GV-ing/ARCHIMEDE/Images/DriverDC.jpg

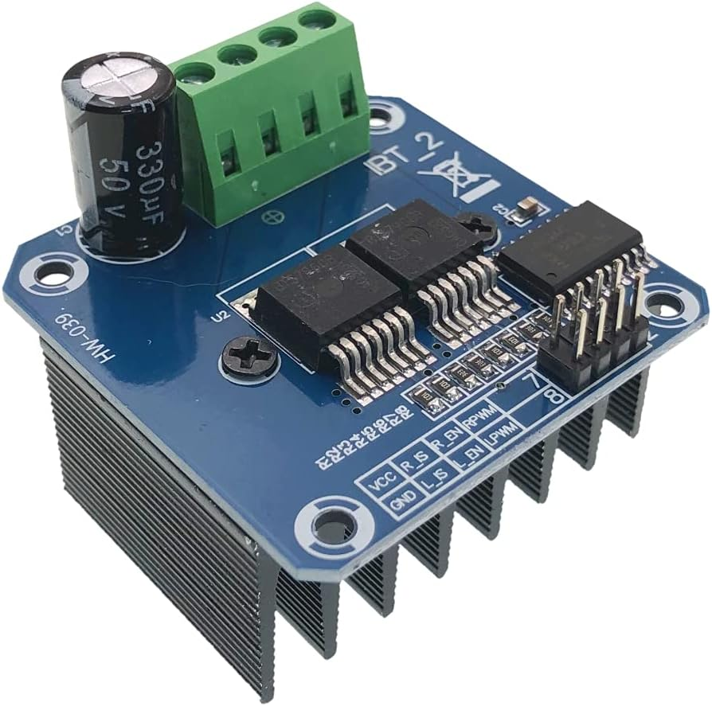
Images/DriverDC.jpg
