GV-ing/ARCHIMEDE/Images/driver.png

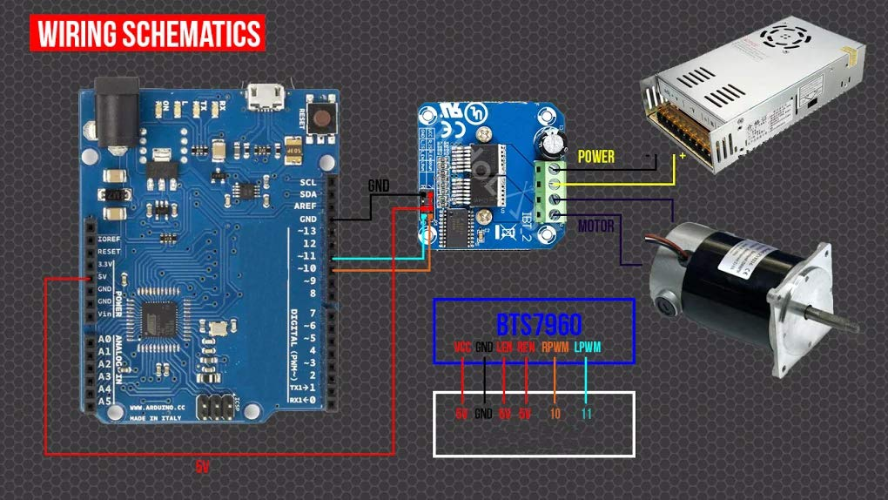
Images/driver.png
