GV-ing/ARCHIMEDE/Thesis/presentazioneTesiGiulioVestri.pdf

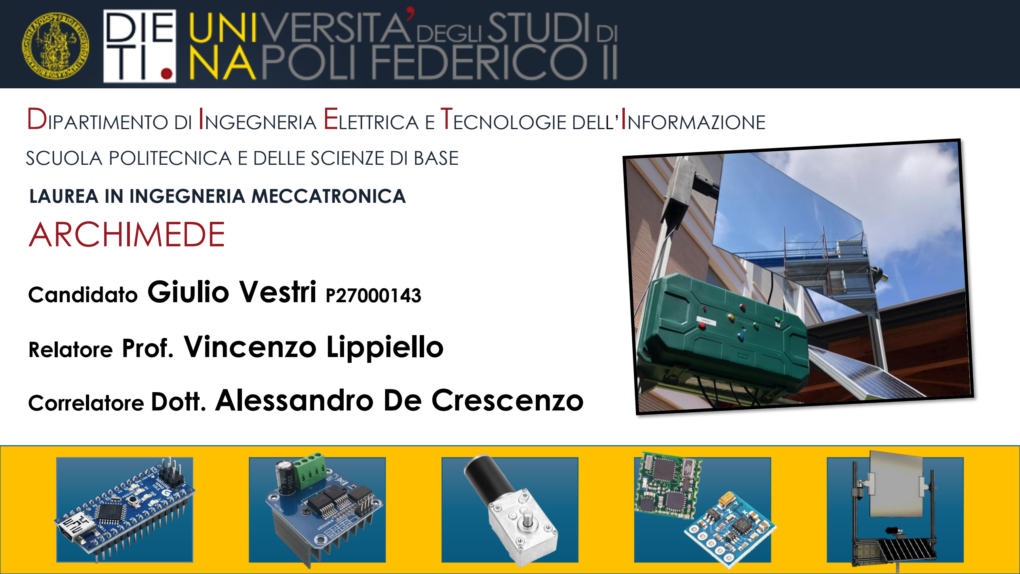
[picture p3: page 2]

DIPARTIMENTO DI INGEGNERIA ELETTRICA E TECNOLOGIE DELL’INFORMAZIONE

SCUOLA POLITECNICA E DELLE SCIENZE DI BASE

# ARCHIMEDE

## Candidato Giulio Vestri P27000143

## Relatore Prof. Vincenzo Lippiello

## Correlatore Dott. Alessandro De Crescenzo

LAUREA IN INGEGNERIA MECCATRONICA

Neabotics

Startup innovativa e
spin-off del laboratorio
di robotica PRISMA Lab

Specializzata nello
sviluppo di soluzioni
robotiche avanzate

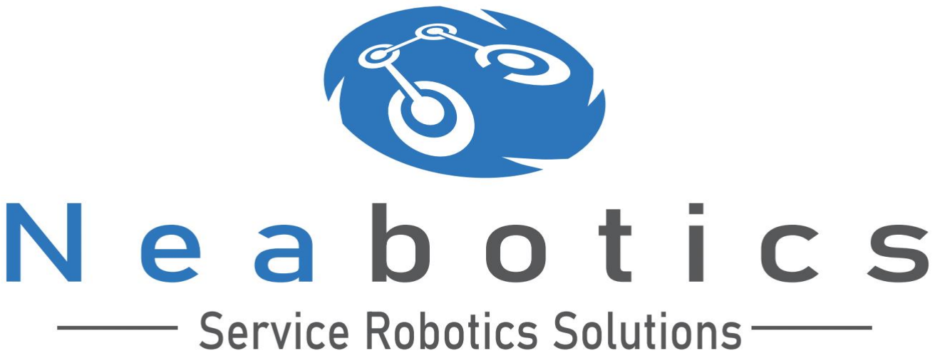
[picture p4: figure]

Steps di progettazione

# Specifiche di progetto

Il sistema doveva essere in grado di riflettere i raggi del sole verso un target selezionabile, modificando il proprio orientamento in base al movimento del sole, al fine di garantire l’illuminazione del target durante l’arco della giornata.

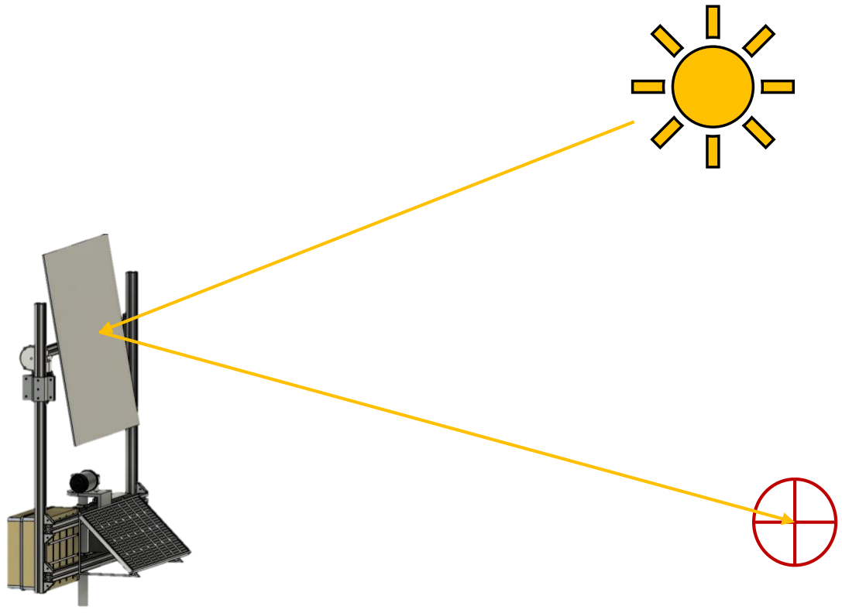
[picture p5: figure]

Steps di progettazione

# Specifiche di progetto

Il sistema doveva essere in grado di riflettere i raggi del sole verso un target selezionabile, modificando il proprio orientamento in base al movimento del sole, al fine di garantire l’illuminazione del target durante l’arco della giornata.

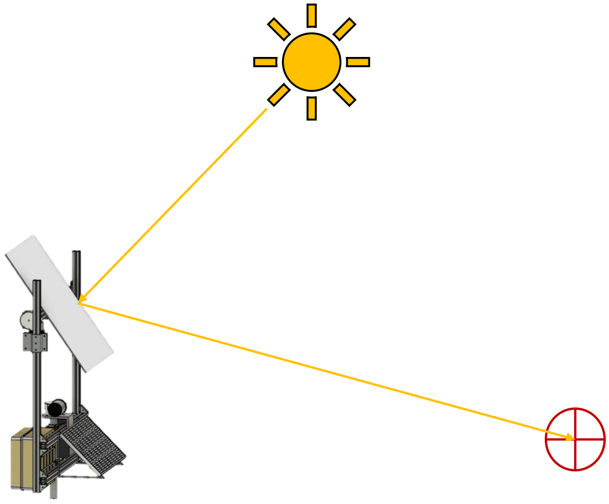
[picture p6: figure]

Steps di progettazione

# Steps di progettazione

## ◆ Tracciamento della posizione solare

## ◆ Selezione coordinate del target

## ◆ Calcolo dell’ orientamento desiderato

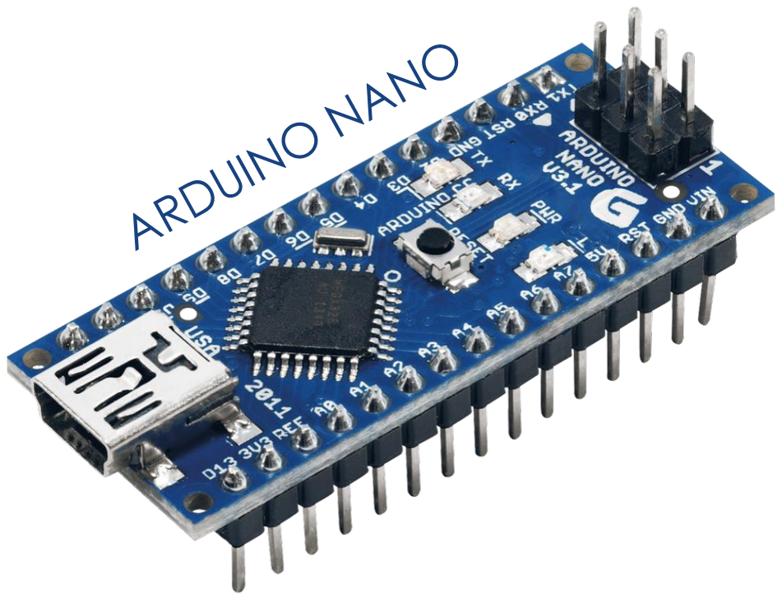
[picture p7: figure]

## ◆ Sensori e attuatori

## ◆ Struttura fisica del sistema

## ◆ Filtraggio del rumore

## ◆ Controllo di posizione

## ◆ Modalità Low-Power

Tracciamento della posizione solare

# Tracciamento della posizione solare

Per tracciare il sole ho usato la libreria solarCalculator.h.
Essa restituisce i valori degli angoli Azimut ed Elevazione che permettono di individuare un qualsiasi oggetto all’interno della sfera celeste.

Le grandezze prese variano a seconda della posizione, inserita

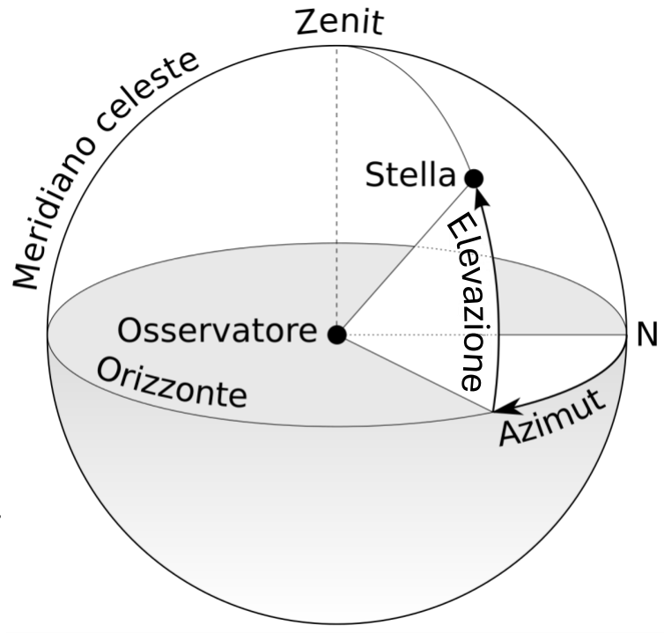
[picture p8: figure]
a zio

manualmente come latitudine e longitudine e della data, calcolata in UTC.

Azimut | Angolo rispetto al nord magnetico [0°,360°]
Elevazione | Angolo formato con l’orizzonte [+90°, -90°]

# Selezione coordinate del target

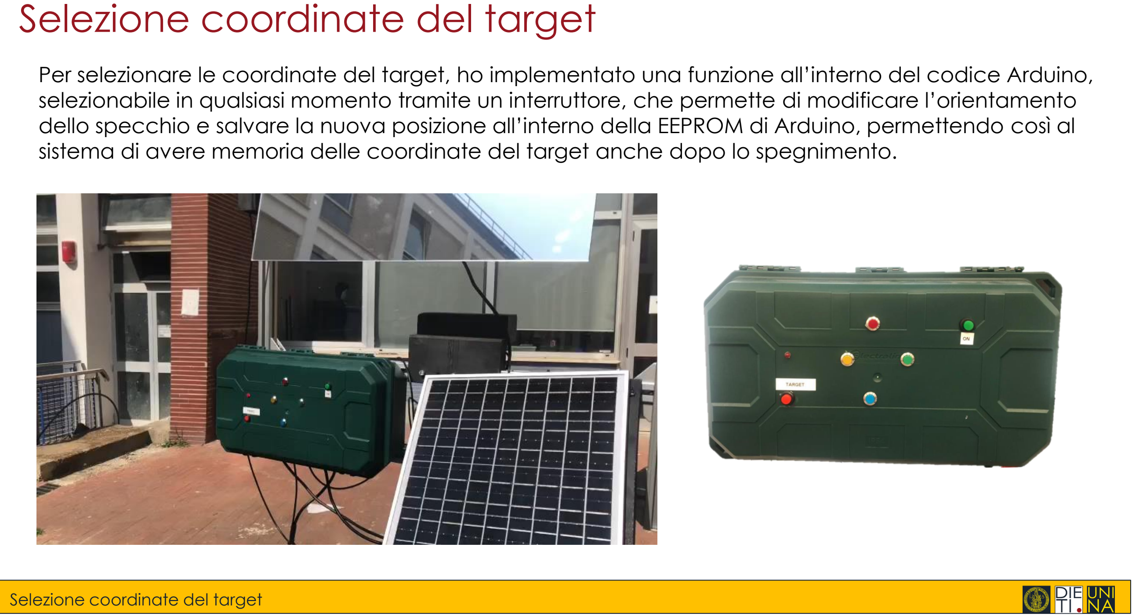
[picture p9: page 8]

Selezione coordinate del target

Per selezionare le coordinate del target, ho implementato una funzione all’interno del codice Arduino, selezionabile in qualsiasi momento tramite un interruttore, che permette di modificare l’orientamento dello specchio e salvare la nuova posizione all’interno della EEPROM di Arduino, permettendo così al sistema di avere memoria delle coordinate del target anche dopo lo spegnimento.

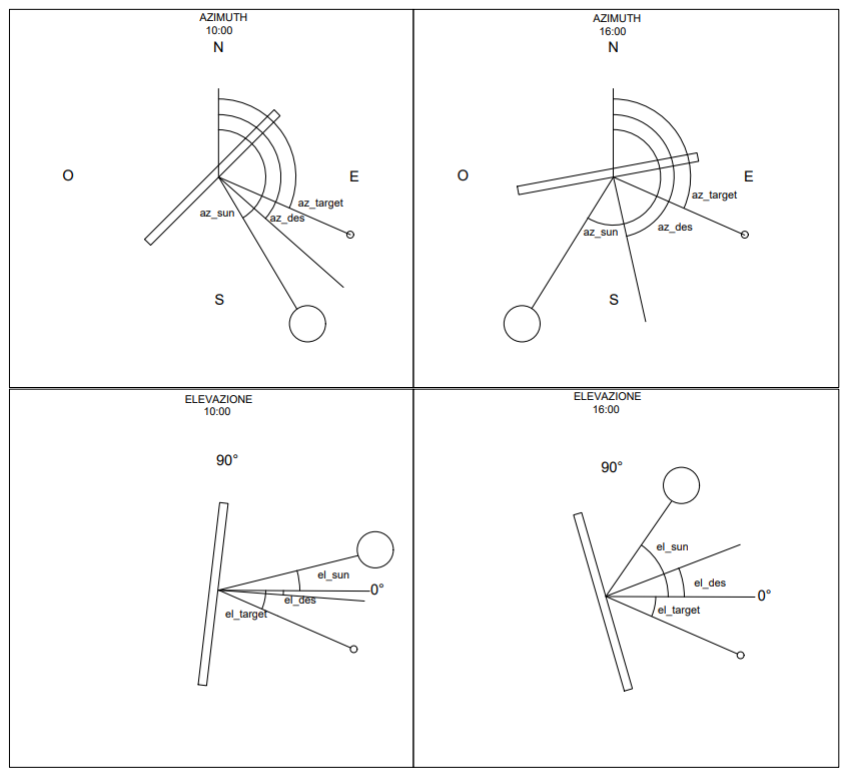
[picture p10: figure]

Calcolo dell’ orientamento desiderato

# Calcolo dell’ orientamento desiderato

Il sistema doveva
essere in grado di
riflettere i raggi del
sole su un target
desiderato, attraverso
uno specchio piano.

Conoscendo le
coordinate del Sole e
quelle del target nella
sfera celeste, per
garantire la riflessione
lo specchio doveva
essere orientato in
modo che la normale
coincidesse con
l’angolo medio tra
target e sole.

azdes =

aztarget + azsun
2

eldes =

eltarget + elsun
2

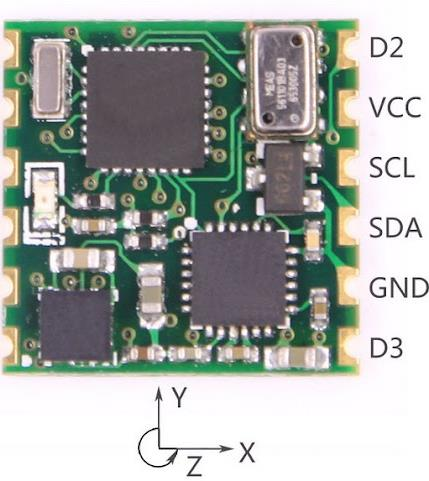
[picture p11: figure]

Sensori e attuatori 1/2

# Sensori e attuatori 1/2

Per permettere il controllo in posizione è necessario effettuare una retroazione tramite dei sensori che possano restituire informazioni utili rispetto all’orientamento dello specchio.

Azimut
L’ azimut è ricavato da un magnetometro GY-271 collegato tramite I2C

Elevazione

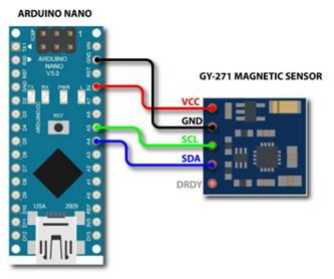
[picture p12: figure]

L’elevazione è ottenuta tramite un WIT-IMU e la lettura dell’angolo di rotazione attorno all’asse x

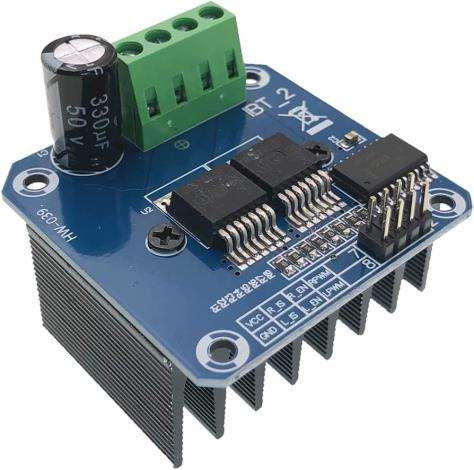
[picture p13: figure]

Sensori e attuatori 2/2

# Sensori e attuatori 2/2

Gli attuatori dovevano essere in grado di far ruotare il sistema a velocità controllata. Si è optato per un motore con moto riduzione ed un driver per il controllo tramite PWM.

Driver ZK BTS7960B
Attraverso segnali PWM permette di pilotare velocità e senso di rotazione dei motori

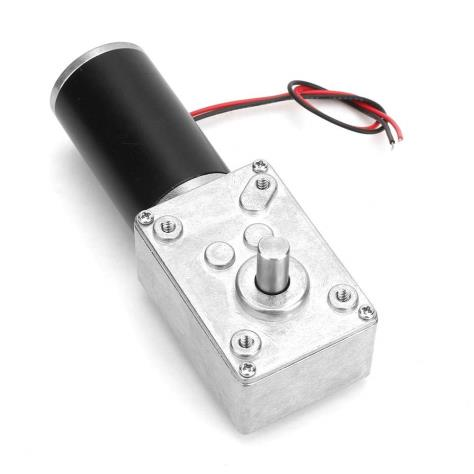
[picture p14: figure]

Motori 12V
- velocità angolare massima di 10rpm
- corrente nominale minore di 1.6A
- coppia massima di 70 Kg ∗ cm

# Struttura fisica del sistema 1/2

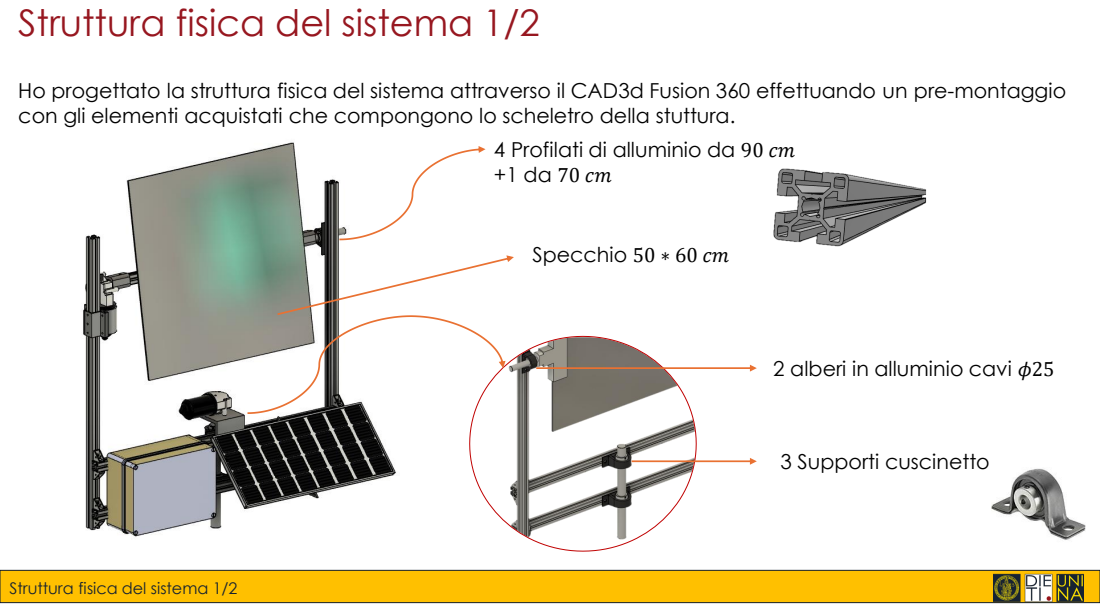
[picture p15: page 12]
3 Supporti cuscinetto; Specchio 50 ∗ 60 cm

Ho progettato la struttura fisica del sistema attraverso il CAD3d Fusion 360 effettuando un pre-montaggio
con gli elementi acquistati che compongono lo scheletro della stuttura.

4 Profilati di alluminio da 90 cm

2 alberi in alluminio cavi φ25

Struttura fisica del sistema 1/2

# Struttura fisica del sistema 2/2

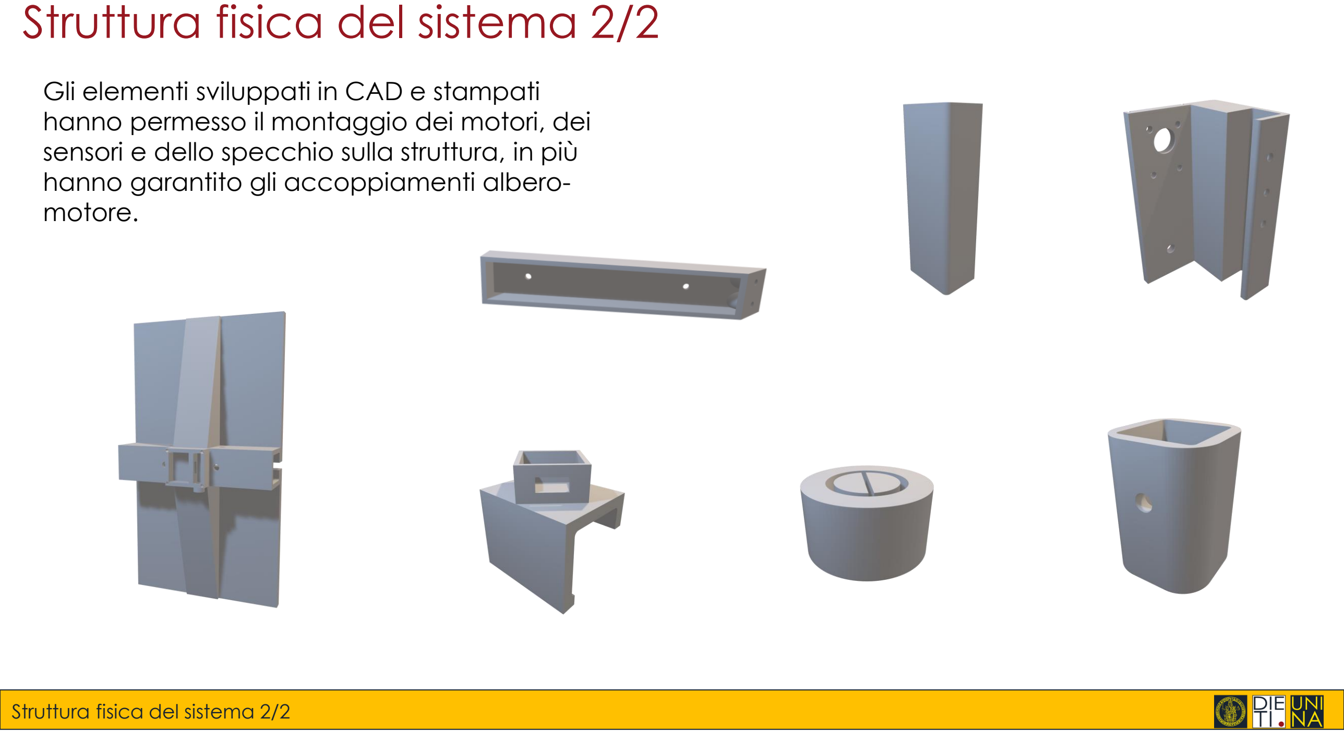
[picture p16: page 13]

Struttura fisica del sistema 2/2

Gli elementi sviluppati in CAD e stampati hanno permesso il montaggio dei motori, dei sensori e dello specchio sulla struttura, in più hanno garantito gli accoppiamenti albero-motore.

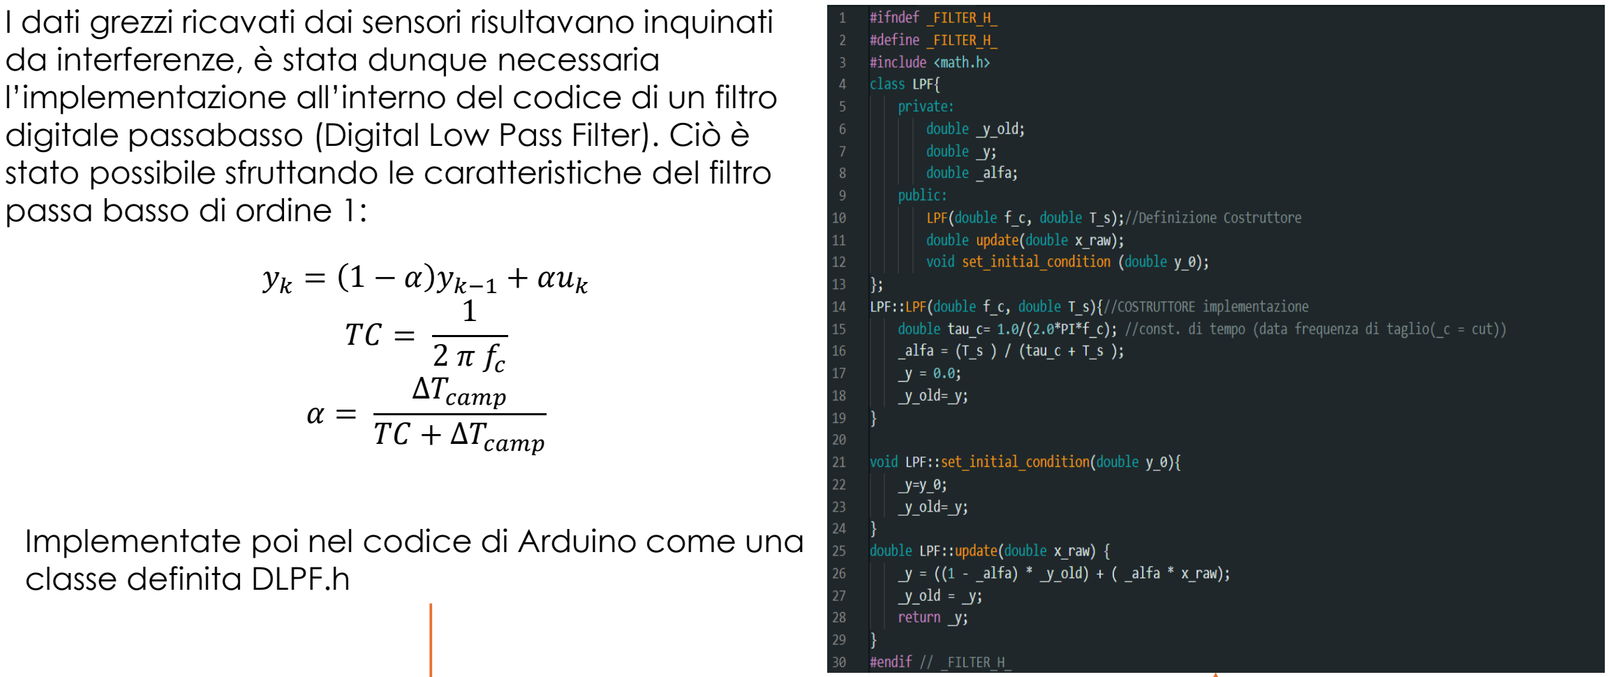
[picture p17: figure]
passa basso di ordine 1:; yk = 1 − α yk−1 + αuk; ∆Tcamp TC + ∆Tcamp; classe definita DLPF.h

Filtraggio del rumore 1/2

# Filtraggio del rumore 1/2

I dati grezzi ricavati dai sensori risultavano inquinati da interferenze, è stata dunque necessaria l’implementazione all’interno del codice di un filtro digitale passabasso (Digital Low Pass Filter). Ciò è stato possibile sfruttando le caratteristiche del filtro

Implementate poi nel codice di Arduino come una

# Filtraggio del rumore 2/2

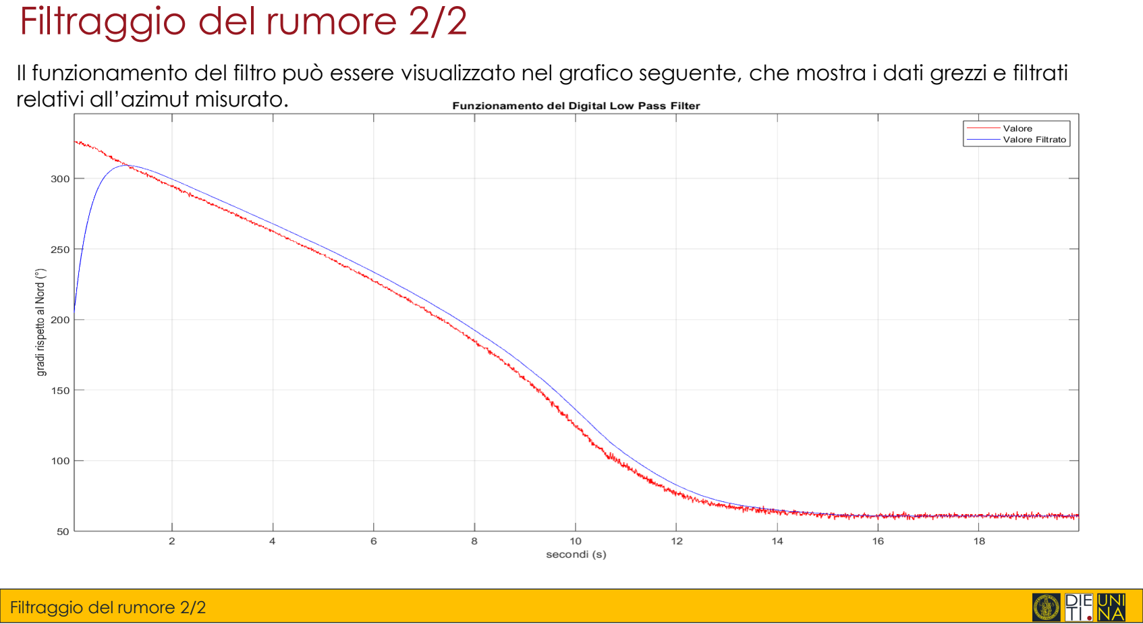
[picture p18: page 15]

Filtraggio del rumore 2/2

Il funzionamento del filtro può essere visualizzato nel grafico seguente, che mostra i dati grezzi e filtrati relativi all’azimut misurato.

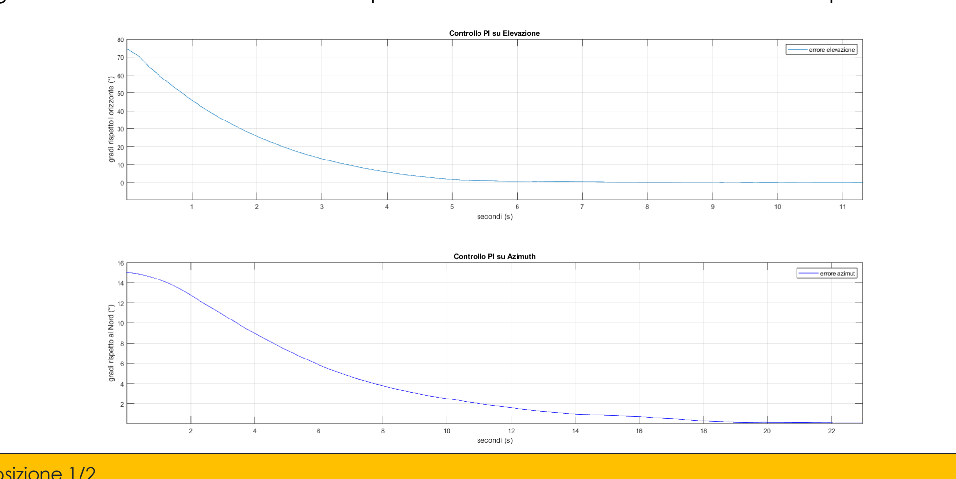
[picture p19: figure]

Controllo di posizione 1/2

# Controllo di posizione 1/2

Il controllo in posizione è gestito da un controllore PI implementato all’interno del codice Arduino come classe (PI.h).
Essa prende in ingresso l’errore e i guadagni proporzionali ed integrato per generare un segnale che poi andrà a pilotare la potenza fornita ai motori.
I guadagni sono stati scelti attraverso un processo di trial and error e sono diversi per elevazione e azimut.

# Controllo di posizione 2/2

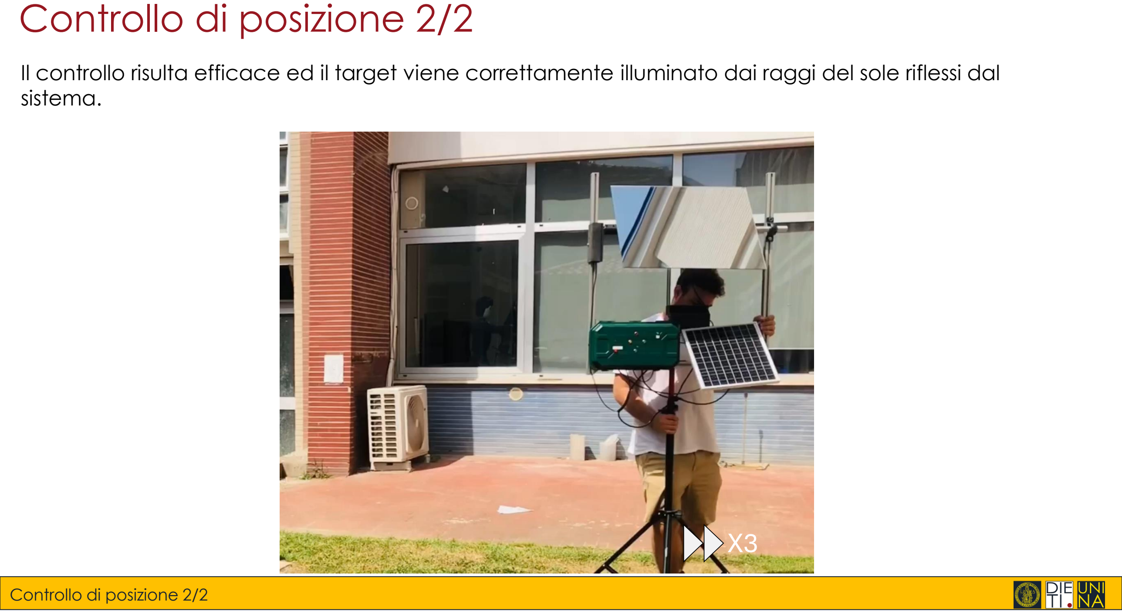
[picture p20: page 17]

Controllo di posizione 2/2

Il controllo risulta efficace ed il target viene correttamente illuminato dai raggi del sole riflessi dal sistema.

X3

Modalità Low-Power

# Modalità Low-Power

Grazie alla libreria LowPower.h il sistema è in grado entrare in una modalità di basso consumo risparmiando energia. Essendo la variazione delle coordinate solari molto lenta, il codice prevede di richiamare questa funzione in maniera periodica durante l’arco della giornata, al fine di ridurre il consumo.

È stata sviluppata inoltre una modalità notturna, che permette al sistema di entrare automaticamente in modalità Low-Power quando ottiene una lettura negativa dell’elevazione solare, essendo quest’ultima possibile solo durante le ore notturne.

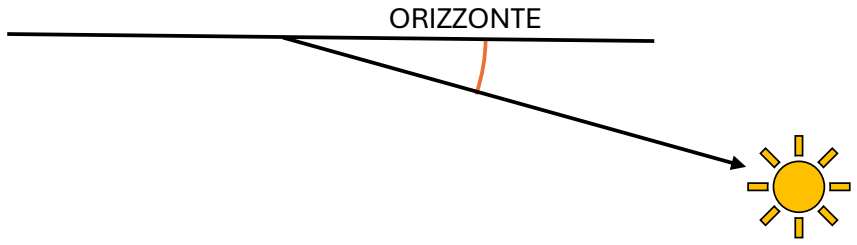
[picture p21: figure]
ORIZZONTE

# Grazie per l’attenzione
