GV-ing/ARCHIMEDE/Images/albero-motore.png

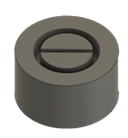
Images/albero-motore.png
