GV-ing/ARCHIMEDE/Images/albero-prof.png

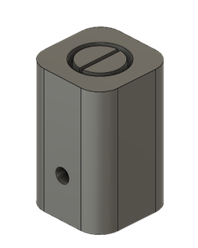
Images/albero-prof.png
