GV-ing/ARCHIMEDE/Images/ARCHIMEDE_ipo.jpg

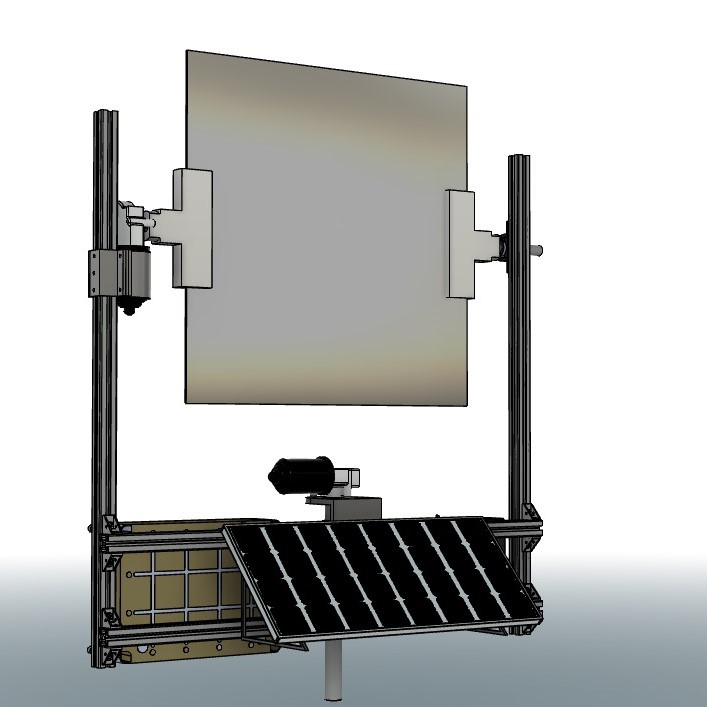
Images/ARCHIMEDE_ipo.jpg
