GV-ing/ARCHIMEDE/Images/ARCHIMEDE_ipo_sist.jpg

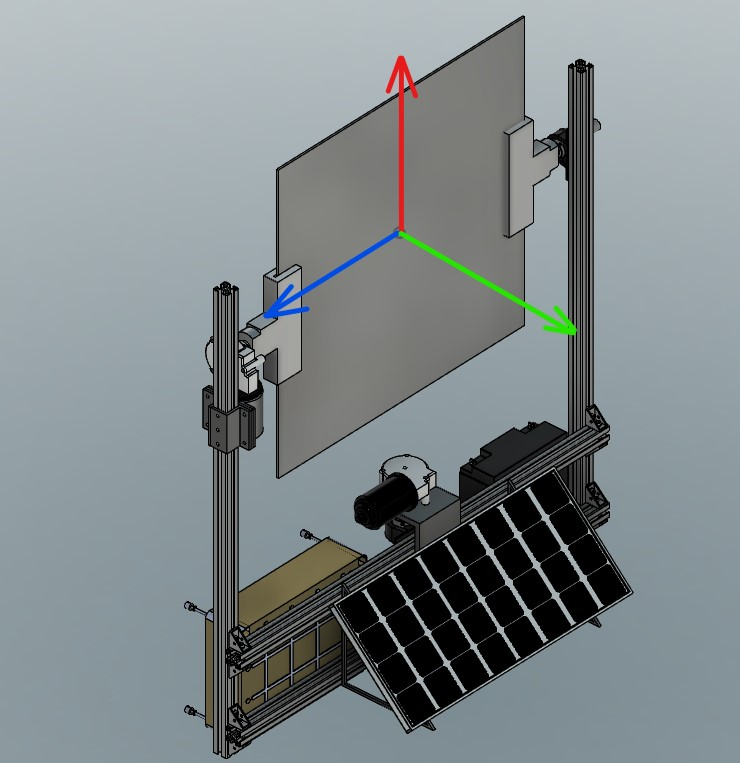
Images/ARCHIMEDE_ipo_sist.jpg
