GV-ing/ARCHIMEDE/Images/ARCHIMEDE_ipotetico.png

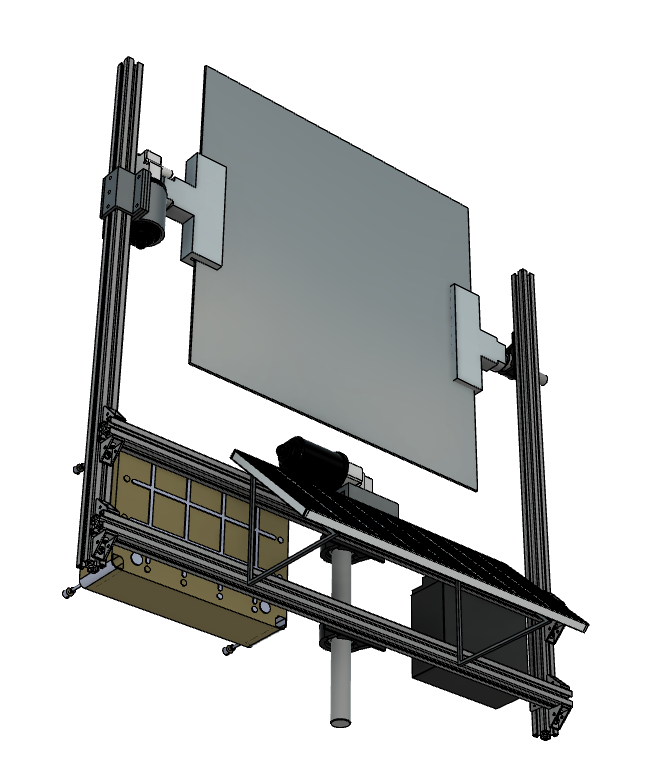
Images/ARCHIMEDE_ipotetico.png
