GV-ing/ARCHIMEDE/Images/ARCHIMEDE_real.jpg

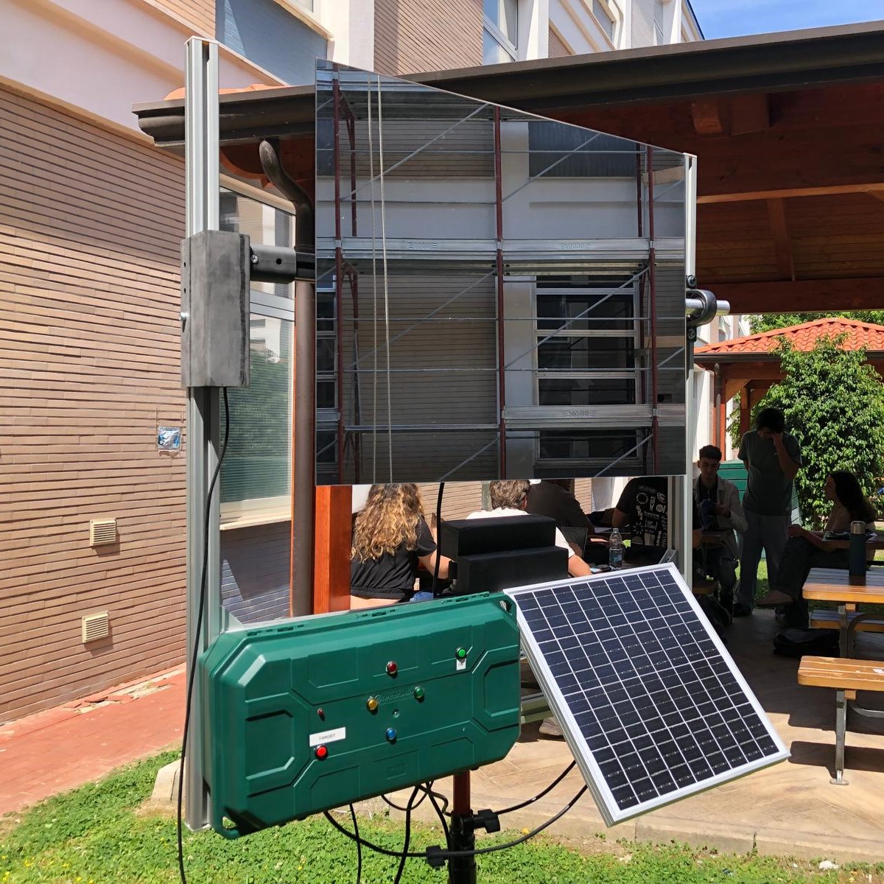
Images/ARCHIMEDE_real.jpg
