GV-ing/ARCHIMEDE/Images/ARCHIMEDE_reale.jpg

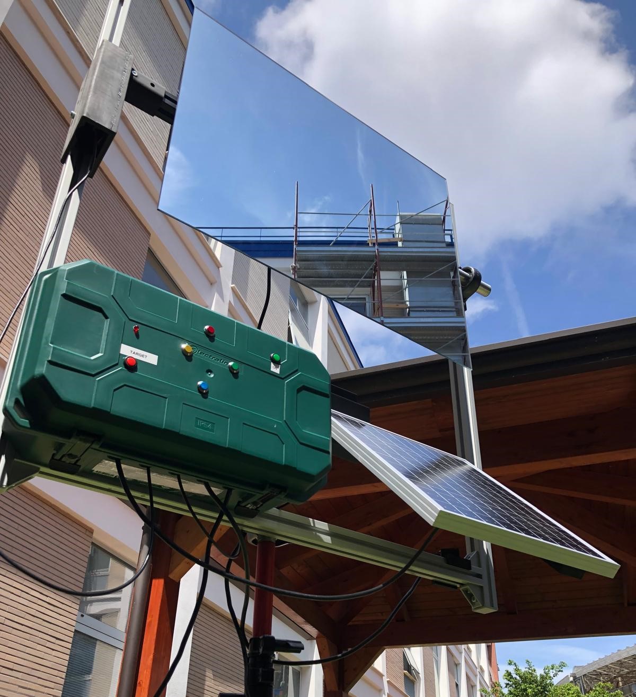
Images/ARCHIMEDE_reale.jpg
