GV-ing/ARCHIMEDE/Images/box-motore-az.png

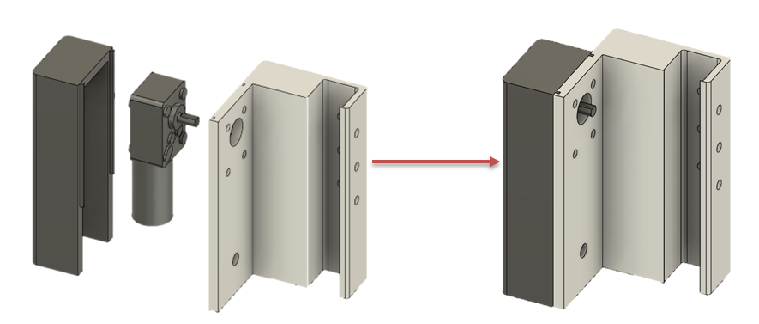
Images/box-motore-az.png
