GV-ing/ARCHIMEDE/Images/box-motore-el.png

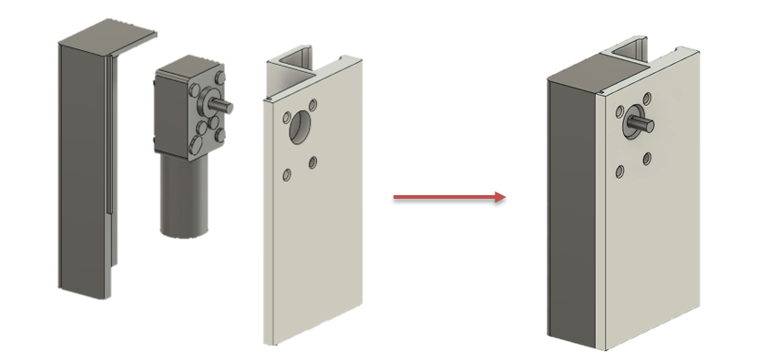
Images/box-motore-el.png
