GV-ing/ARCHIMEDE/Images/box_magn.png

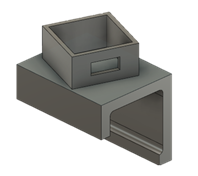
Images/box_magn.png
