GV-ing/ARCHIMEDE/Images/Caricabatterie.jpeg

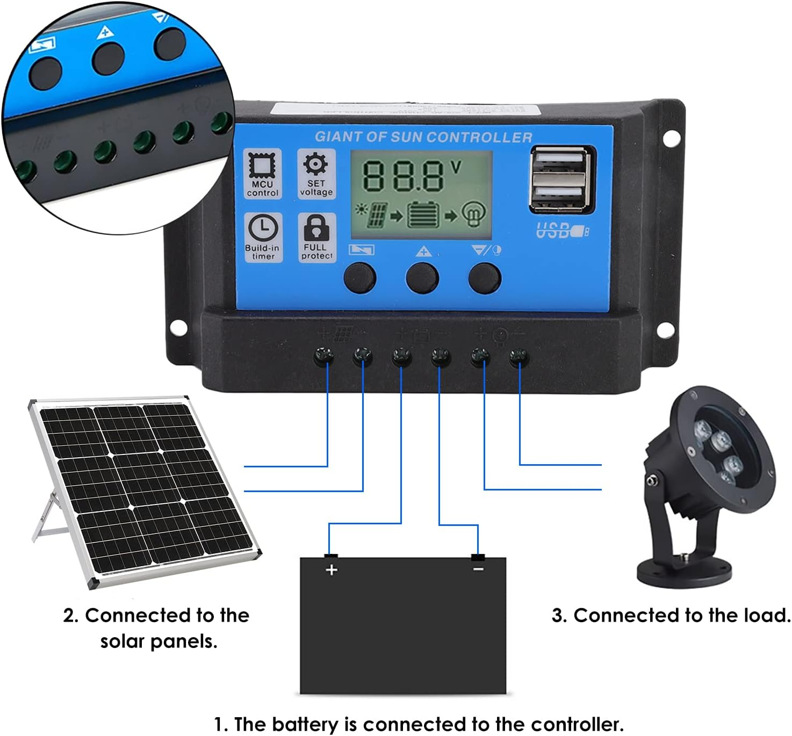
Images/Caricabatterie.jpeg
