GV-ing/ARCHIMEDE/Images/Circuito.png

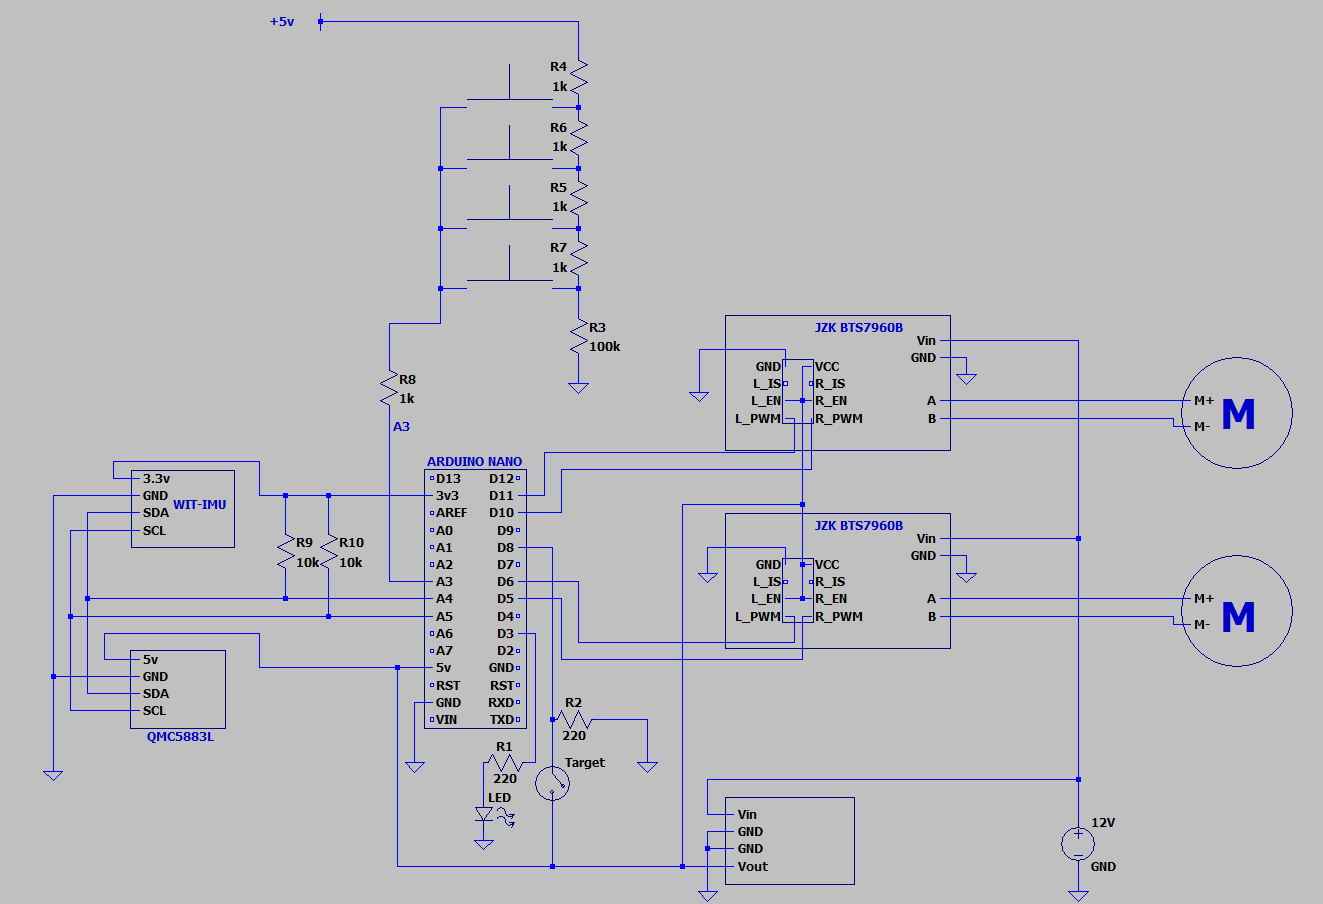
Images/Circuito.png
