GV-ing/ARCHIMEDE/Images/image.png

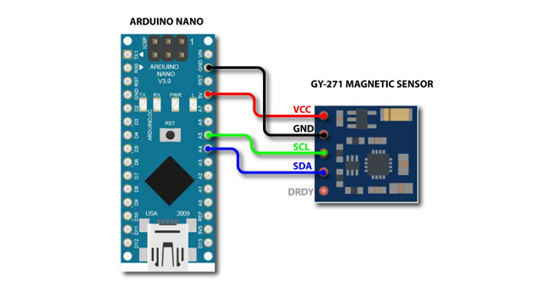
Images/image.png
