GV-ing/ARCHIMEDE/Images/inseguimentoAzimuth.png

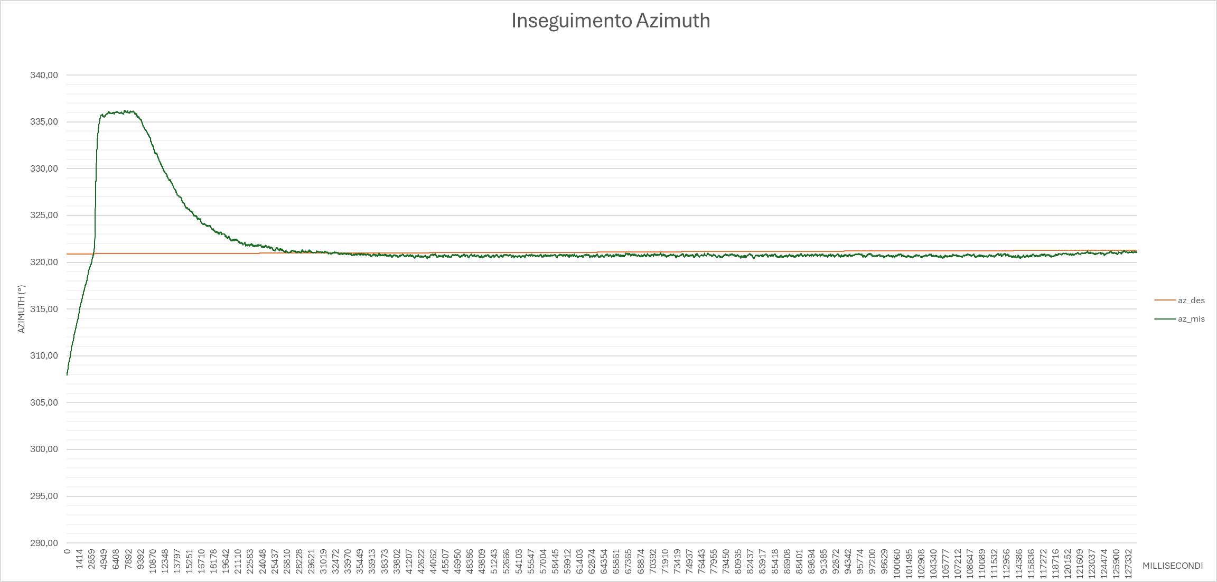
Images/inseguimentoAzimuth.png
