GV-ing/ARCHIMEDE/Images/inseguimentoElevazione.jpeg

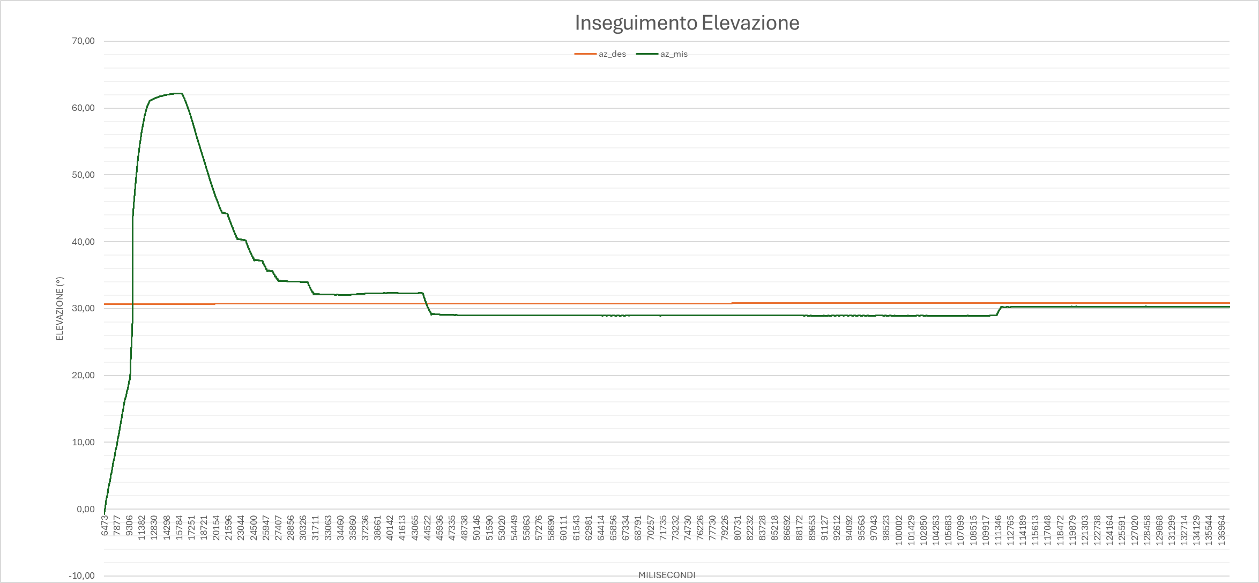
Images/inseguimentoElevazione.jpeg
