GV-ing/ARCHIMEDE/Images/LPF.png

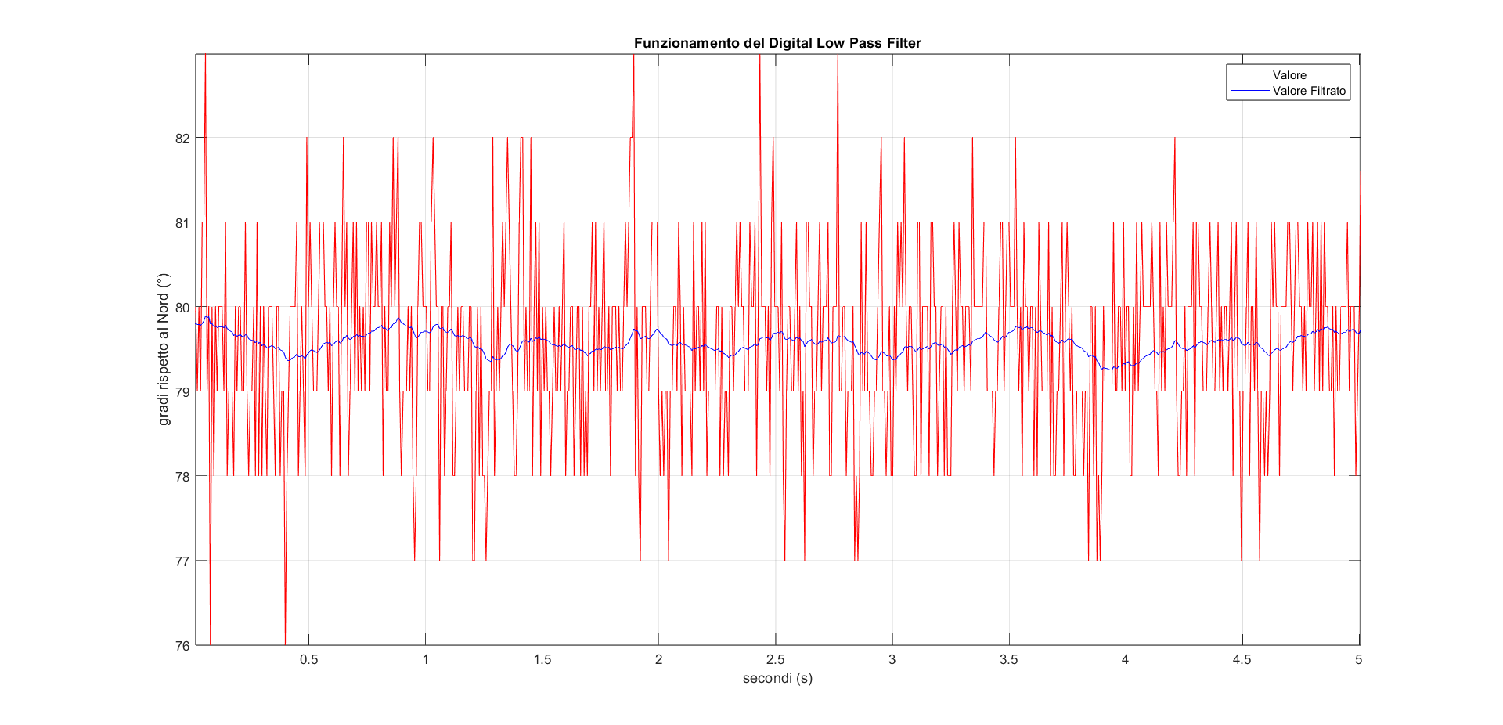
Images/LPF.png
