GV-ing/ARCHIMEDE/Images/LPFfilter.png

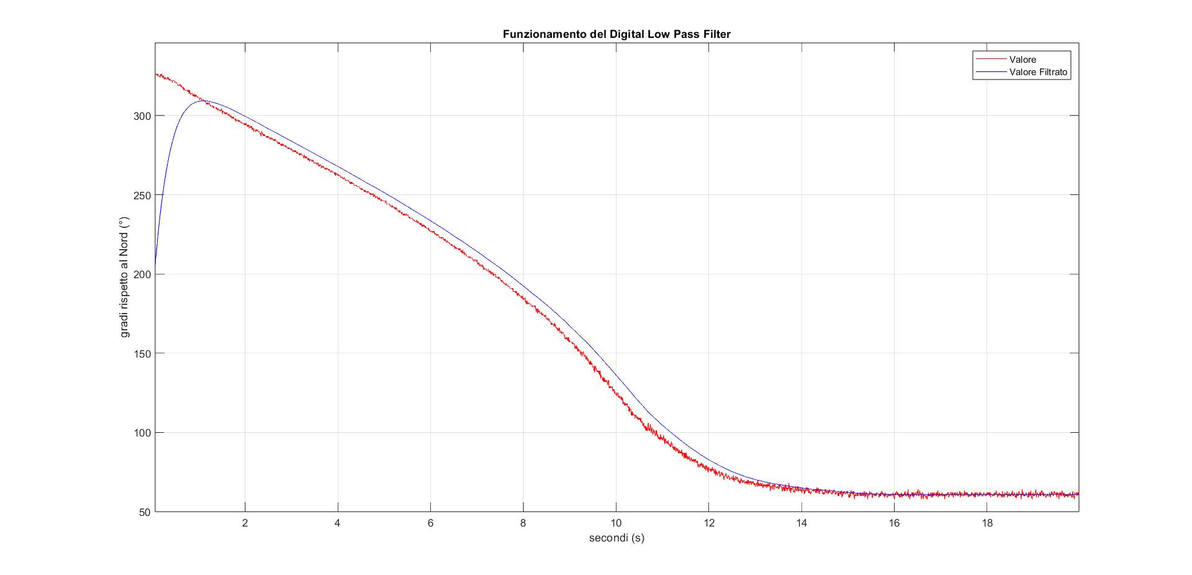
Images/LPFfilter.png
