GV-ing/ARCHIMEDE/Images/PROFILATO.png

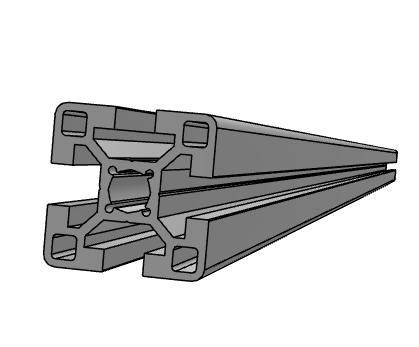
Images/PROFILATO.png
