GV-ing/ARCHIMEDE/Images/PULSANTIERA.jpeg

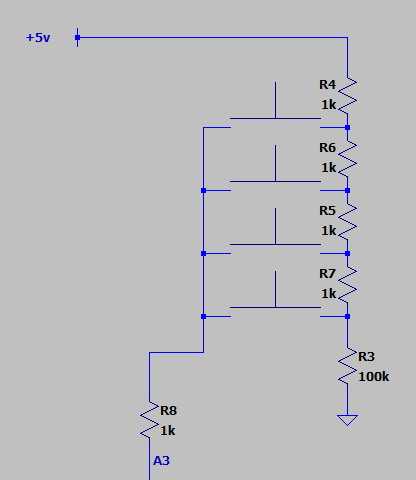
Images/PULSANTIERA.jpeg
