GV-ing/ARCHIMEDE/Images/Rifl.jpeg

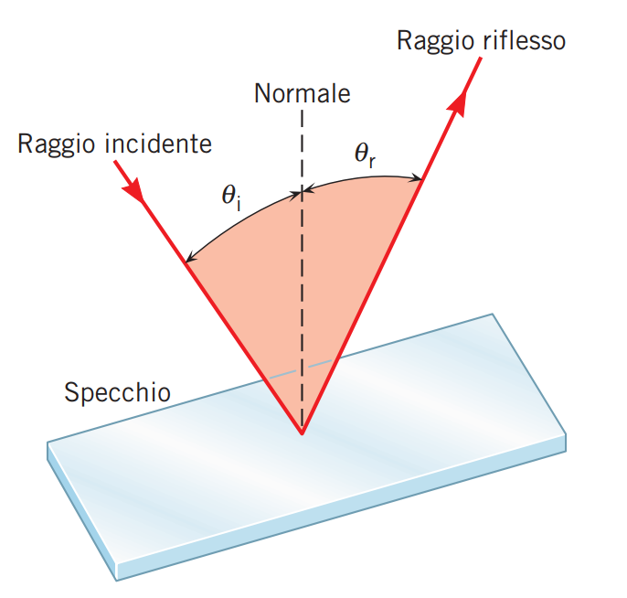
Images/Rifl.jpeg
