GV-ing/ARCHIMEDE/Images/RIFLESSIONE3.jpeg

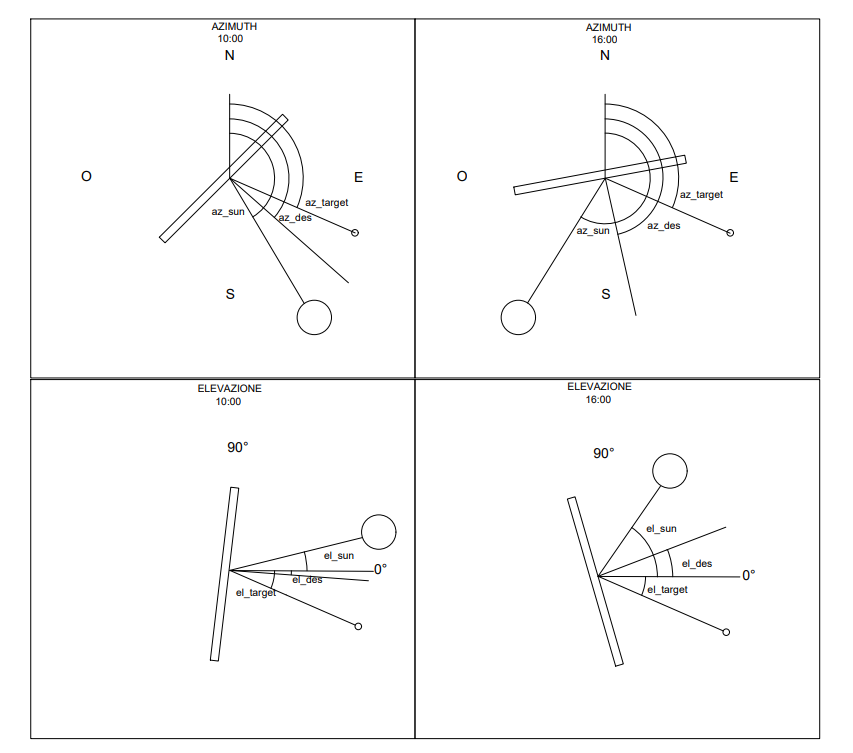
Images/RIFLESSIONE3.jpeg
