GV-ing/ARCHIMEDE/Images/Sistema_1.png

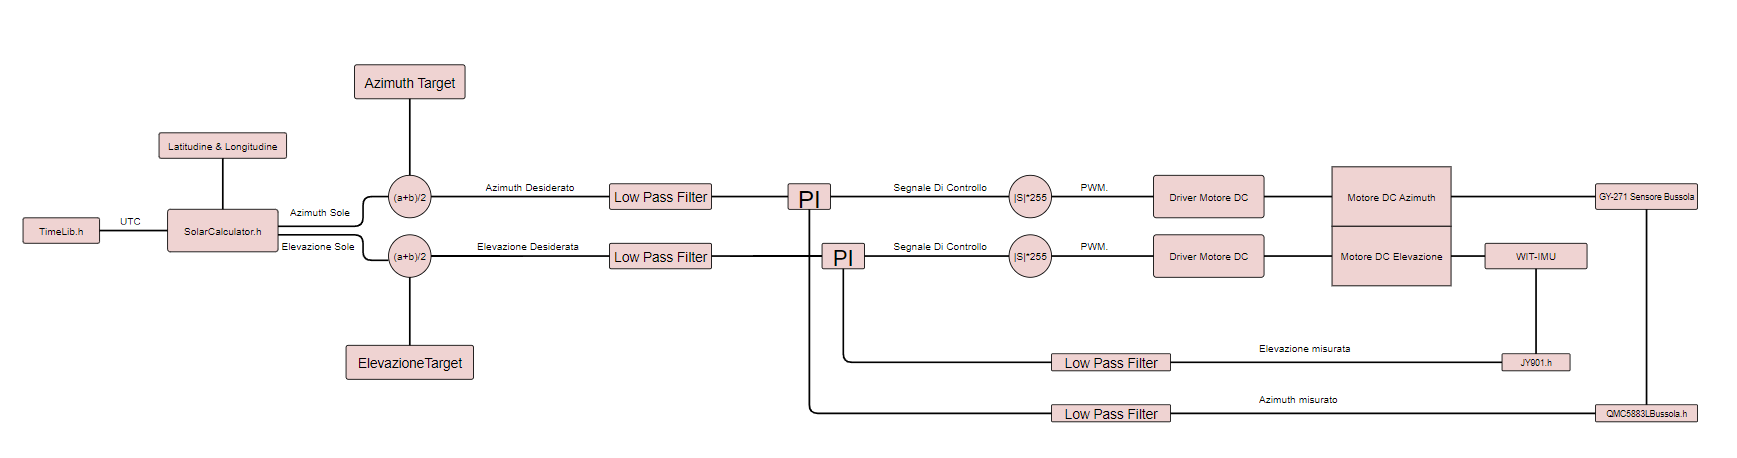
Images/Sistema_1.png
