GV-ing/ARCHIMEDE/Images/staffe angolari.png

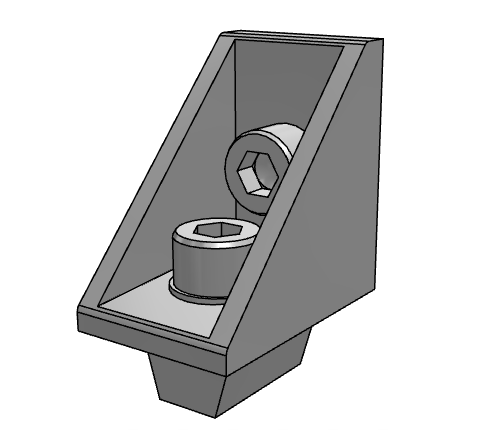
Images/staffe angolari.png
