GV-ing/ARCHIMEDE/Images/Supporti cuscinetto.png

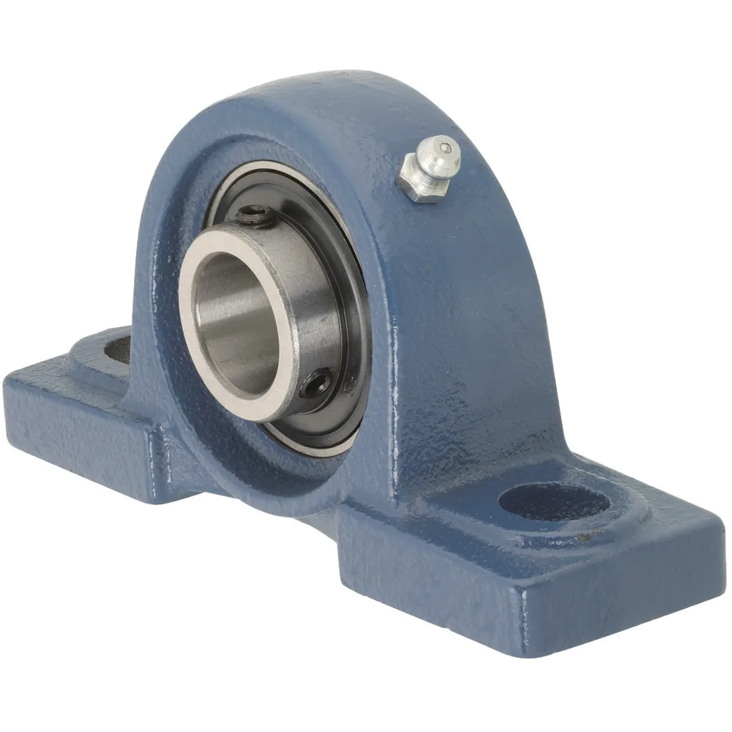
Images/Supporti cuscinetto.png
