GV-ing/ARCHIMEDE/Images/WIT.png

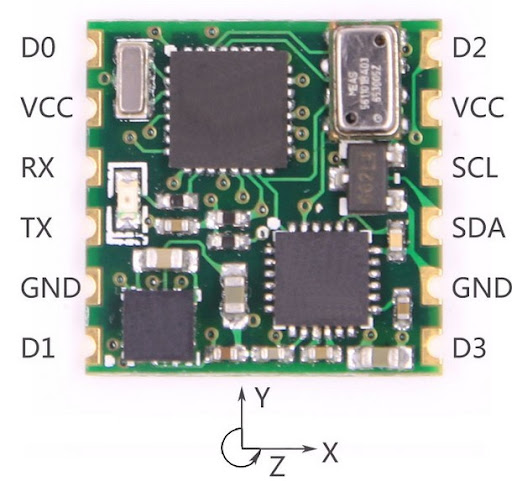
Images/WIT.png
